derek-l8/vision-configured-analog-oscillator/data/pilot-s01/images/s01_p00_l0_r0_001.jpg

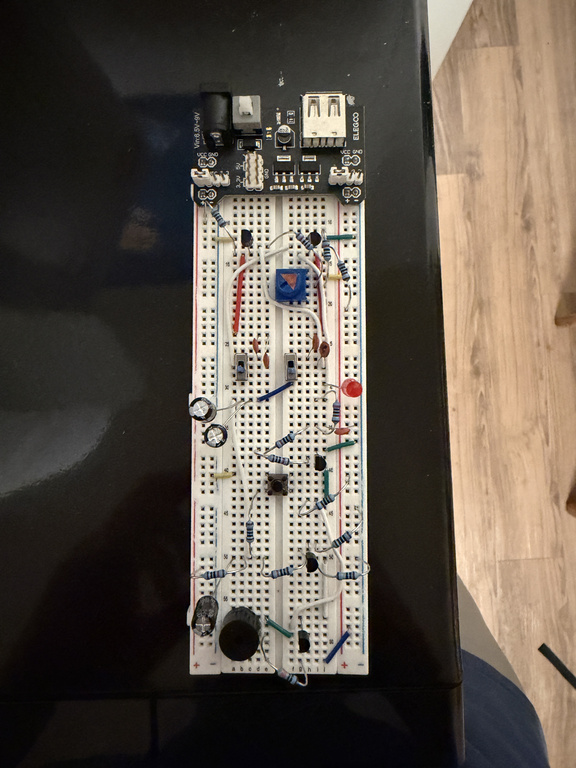
data/pilot-s01/images/s01_p00_l0_r0_001.jpg
