derek-l8/vision-configured-analog-oscillator/data/pilot-s01/images/s01_p00_l1_r0_002.jpg

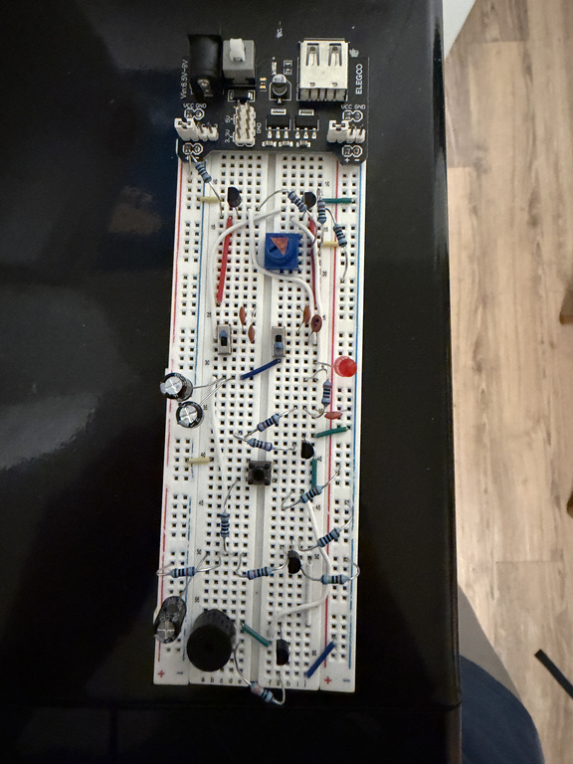
data/pilot-s01/images/s01_p00_l1_r0_002.jpg
