derek-l8/vision-configured-analog-oscillator/data/pilot-s01/images/s01_p00_l1_r1_003.jpg

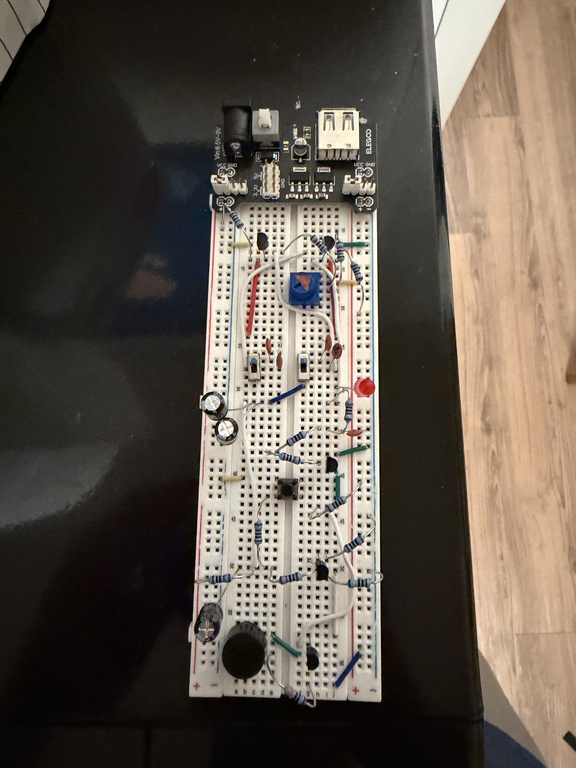
data/pilot-s01/images/s01_p00_l1_r1_003.jpg
