derek-l8/vision-configured-analog-oscillator/data/pilot-s01/images/s01_p01_l0_r0_005.jpg

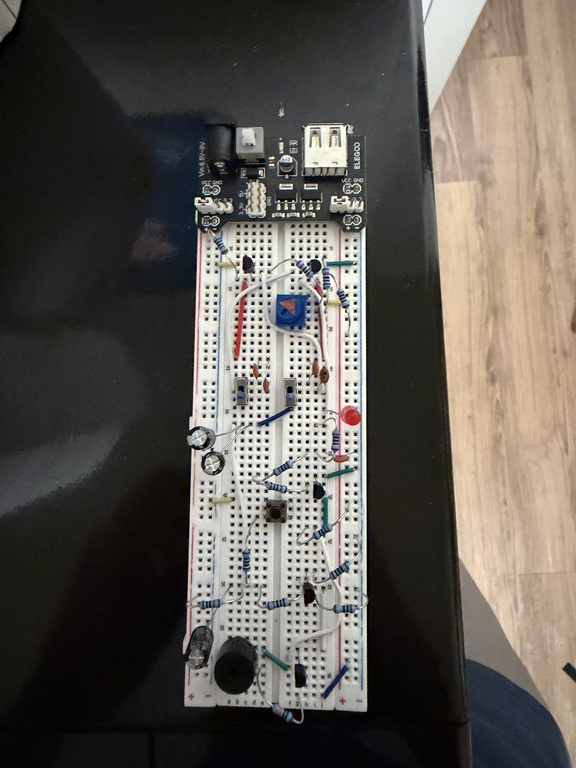
data/pilot-s01/images/s01_p01_l0_r0_005.jpg
