derek-l8/vision-configured-analog-oscillator/data/pilot-s01/images/s01_p01_l1_r0_006.jpg

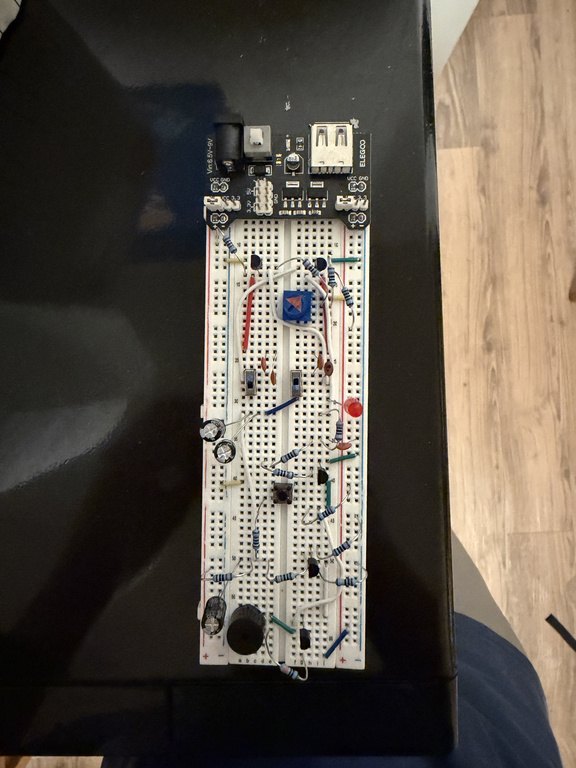
data/pilot-s01/images/s01_p01_l1_r0_006.jpg
