derek-l8/vision-configured-analog-oscillator/data/pilot-s01/images/s01_p02_l0_r1_012.jpg

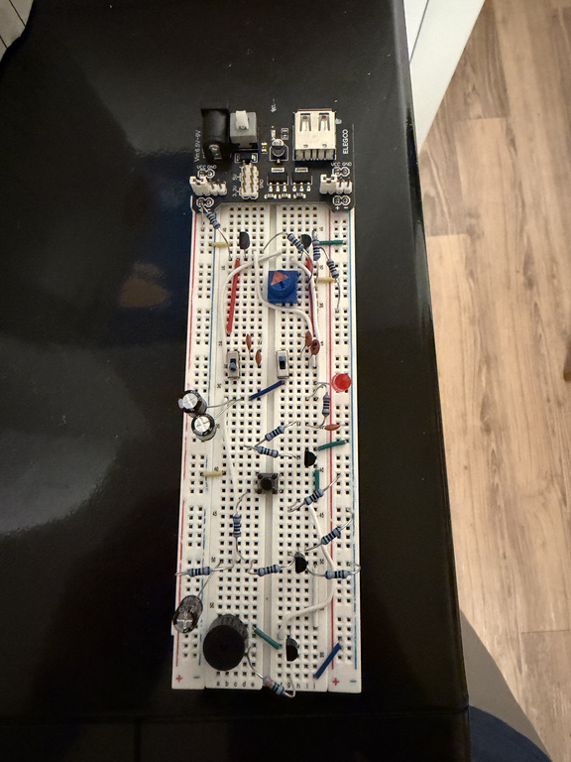
data/pilot-s01/images/s01_p02_l0_r1_012.jpg
