derek-l8/vision-configured-analog-oscillator/data/pilot-s01/images/s01_p02_l1_r1_011.jpg

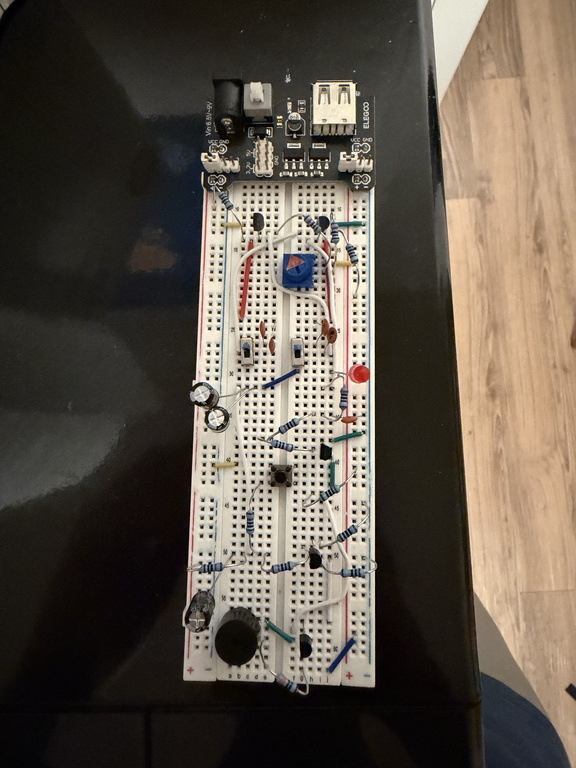
data/pilot-s01/images/s01_p02_l1_r1_011.jpg
