derek-l8/vision-configured-analog-oscillator/data/pilot-s01/images/s01_p03_l0_r0_013.jpg

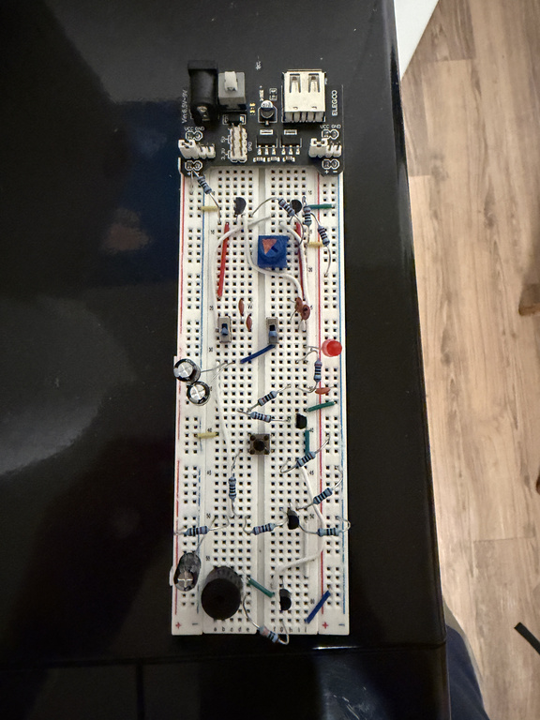
data/pilot-s01/images/s01_p03_l0_r0_013.jpg
