derek-l8/vision-configured-analog-oscillator/data/pilot-s01/images/s01_p03_l1_r0_014.jpg

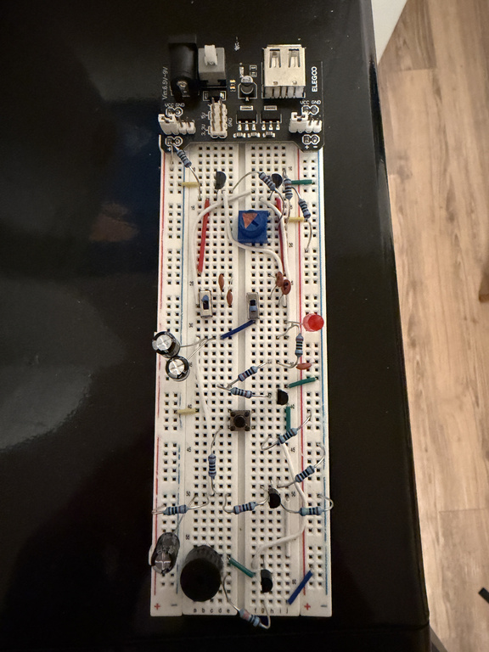
data/pilot-s01/images/s01_p03_l1_r0_014.jpg
