derek-l8/vision-configured-analog-oscillator/data/pilot-s01/images/s01_p04_l0_r0_017.jpg

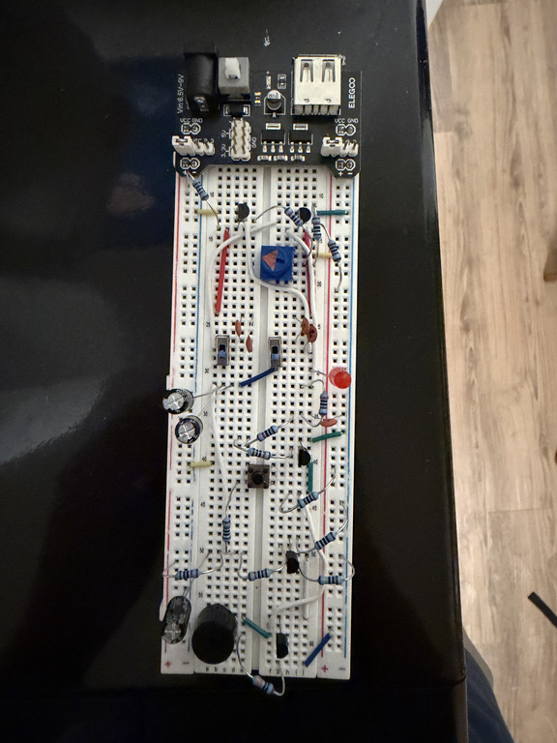
data/pilot-s01/images/s01_p04_l0_r0_017.jpg
