derek-l8/vision-configured-analog-oscillator/data/pilot-s01/images/s01_p04_l1_r1_019.jpg

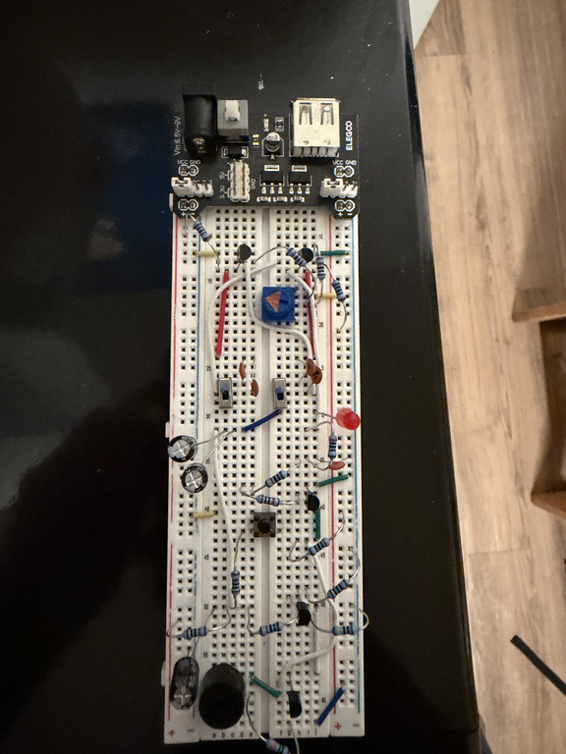
data/pilot-s01/images/s01_p04_l1_r1_019.jpg
