derek-l8/vision-configured-analog-oscillator/data/pilot-s01/images/s01_p05_l0_r0_021.jpg

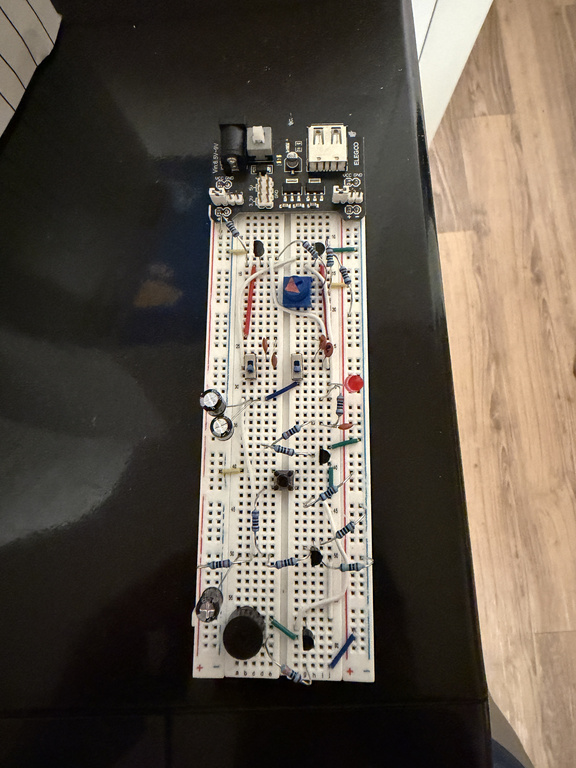
data/pilot-s01/images/s01_p05_l0_r0_021.jpg
