derek-l8/vision-configured-analog-oscillator/data/pilot-s01/images/s01_p05_l1_r0_022.jpg

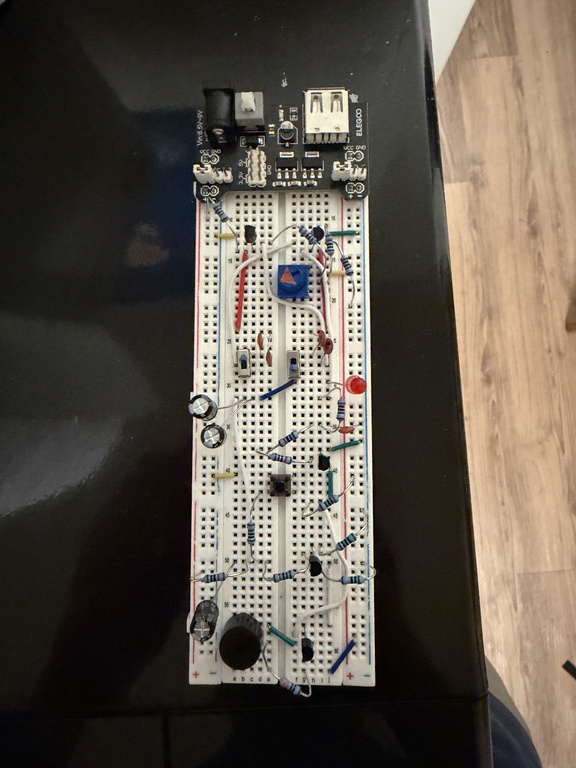
data/pilot-s01/images/s01_p05_l1_r0_022.jpg
