derek-l8/vision-configured-analog-oscillator/data/pilot-s01/images/s01_p06_l0_r1_028.jpg

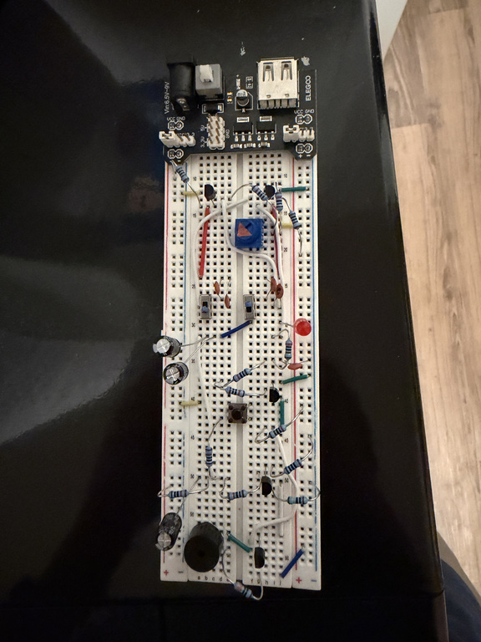
data/pilot-s01/images/s01_p06_l0_r1_028.jpg
