derek-l8/vision-configured-analog-oscillator/data/pilot-s01/images/s01_p06_l1_r1_027.jpg

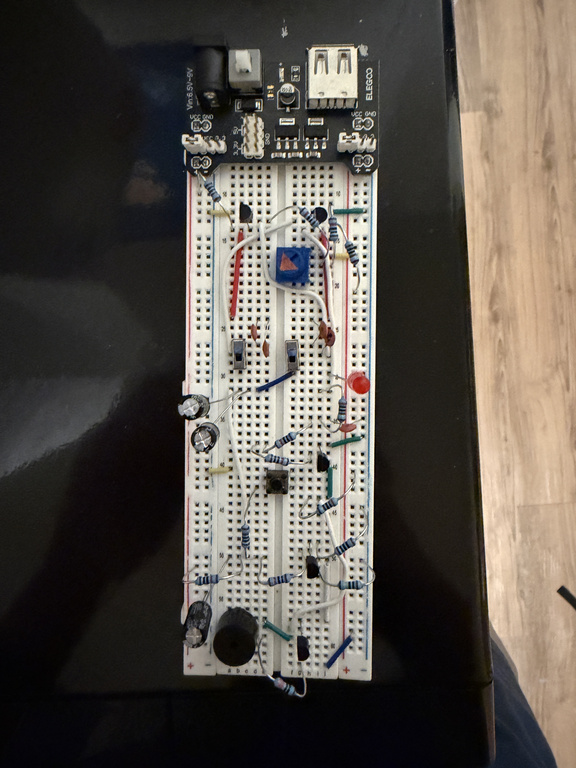
data/pilot-s01/images/s01_p06_l1_r1_027.jpg
