derek-l8/vision-configured-analog-oscillator/data/pilot-s01/images/s01_p07_l0_r0_029.jpg

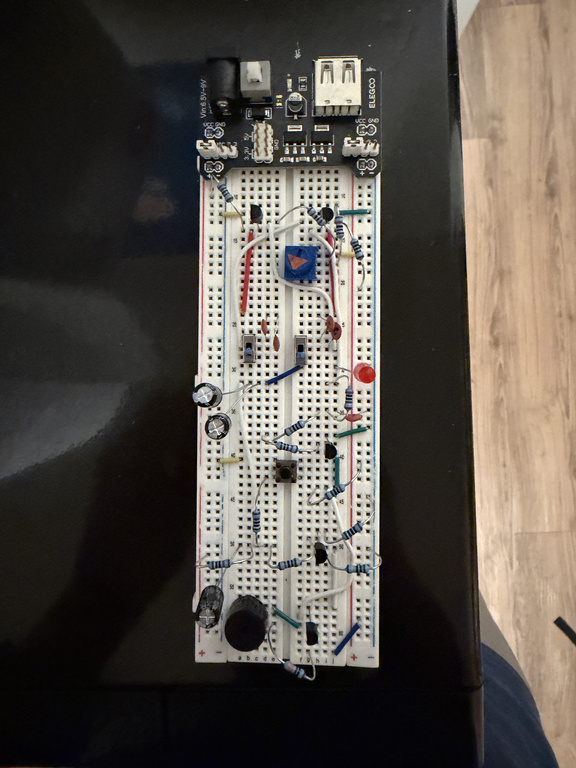
data/pilot-s01/images/s01_p07_l0_r0_029.jpg
