derek-l8/vision-configured-analog-oscillator/data/pilot-s01/images/s01_p07_l1_r0_030.jpg

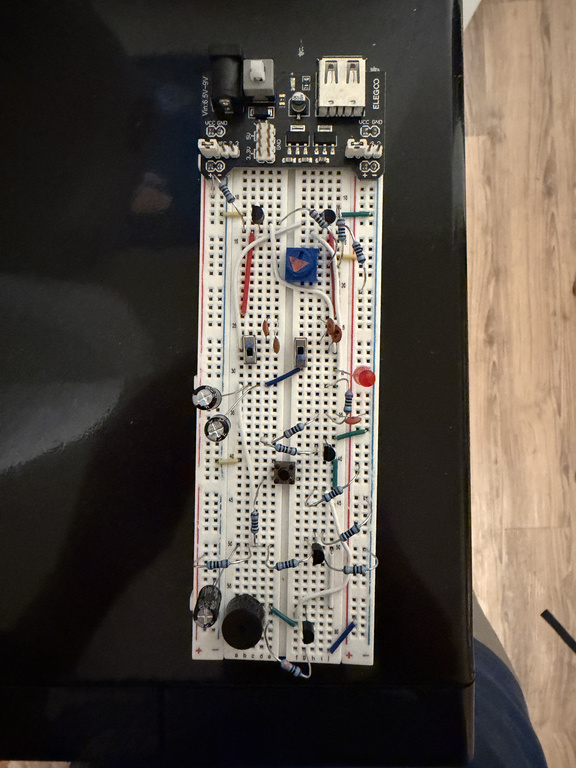
data/pilot-s01/images/s01_p07_l1_r0_030.jpg
