derek-l8/vision-configured-analog-oscillator/data/pilot-s01/images/s01_p08_l0_r0_033.jpg

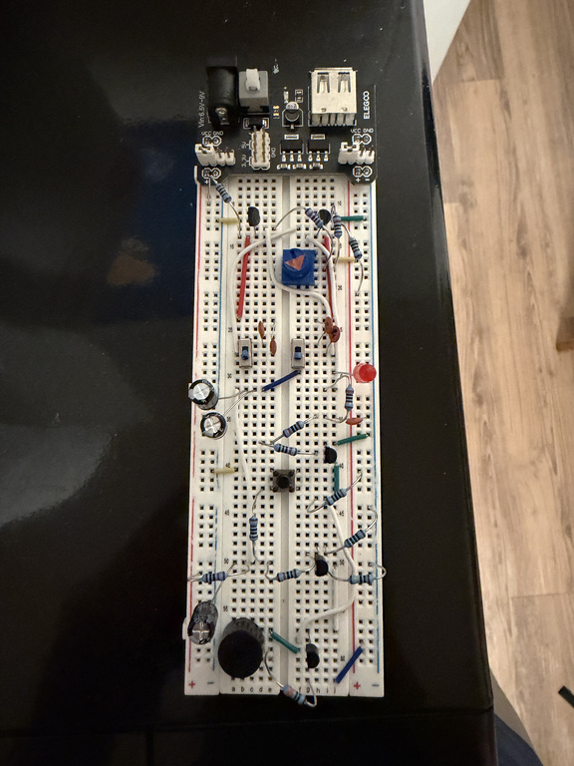
data/pilot-s01/images/s01_p08_l0_r0_033.jpg
