derek-l8/vision-configured-analog-oscillator/data/pilot-s01/images/s01_p09_l0_r0_037.jpg

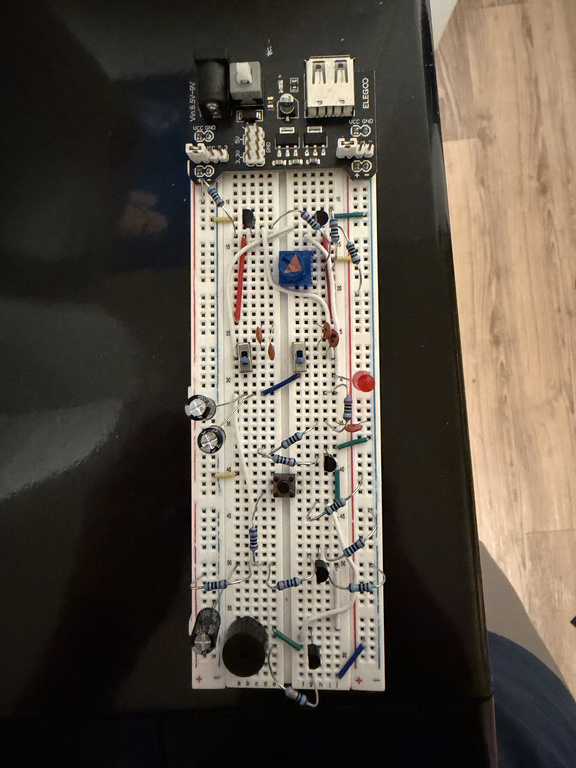
data/pilot-s01/images/s01_p09_l0_r0_037.jpg
