derek-l8/vision-configured-analog-oscillator/data/pilot-s01/images/s01_p09_l0_r1_040.jpg

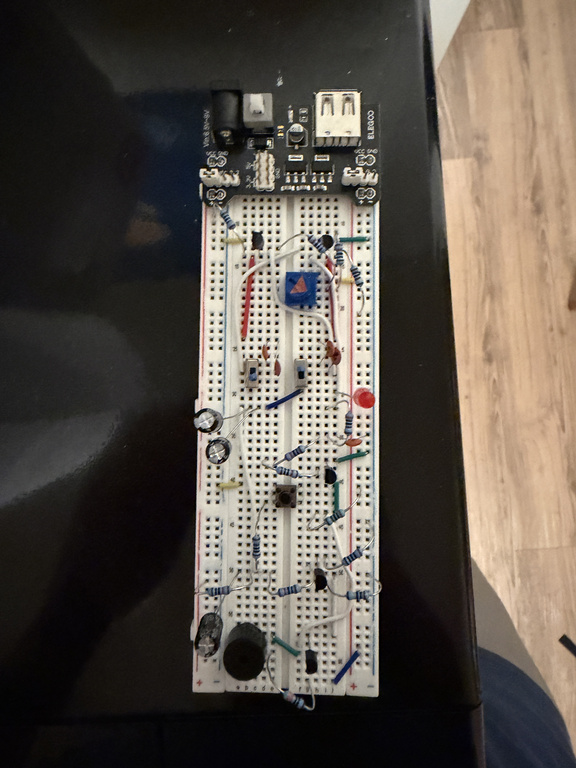
data/pilot-s01/images/s01_p09_l0_r1_040.jpg
