derek-l8/vision-configured-analog-oscillator/data/pilot-s01/images/s01_p09_l1_r1_039.jpg

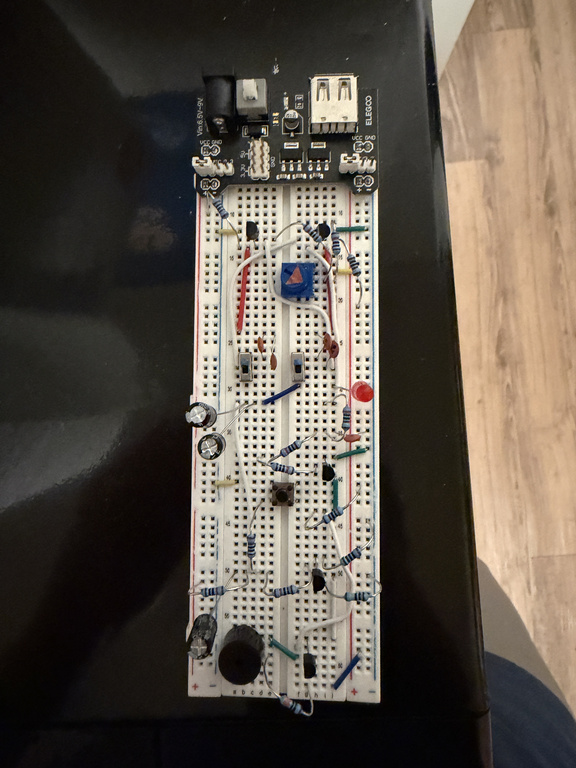
data/pilot-s01/images/s01_p09_l1_r1_039.jpg
