derek-l8/vision-configured-analog-oscillator/hardware/media/breadboard-overhead.JPG

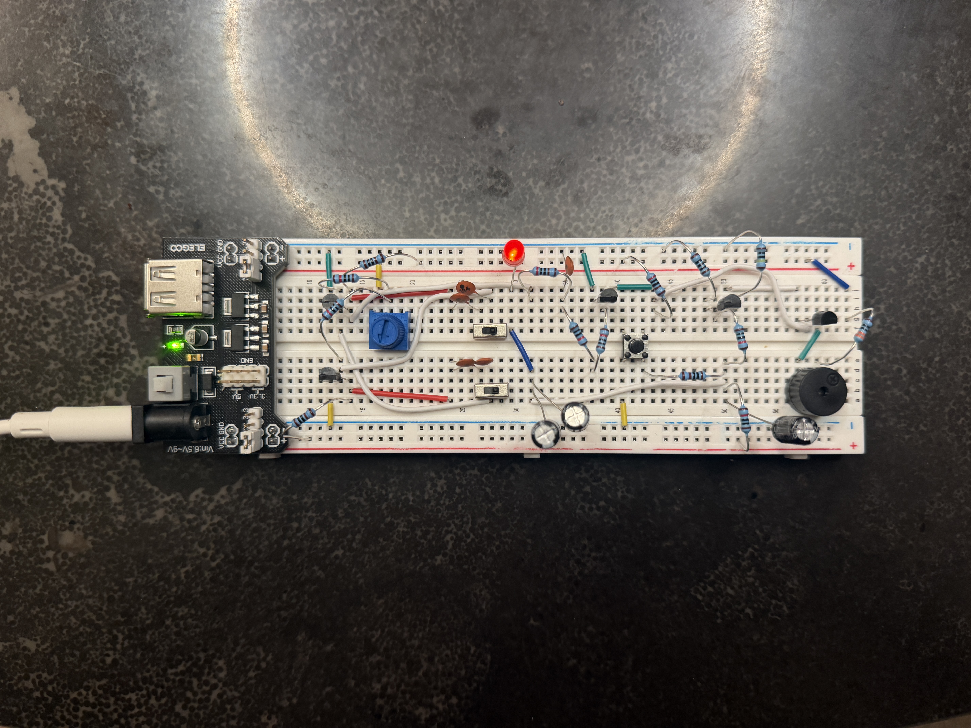
hardware/media/breadboard-overhead.JPG
