derek-l8/vision-configured-analog-oscillator/hardware/media/breadboard-side.JPG

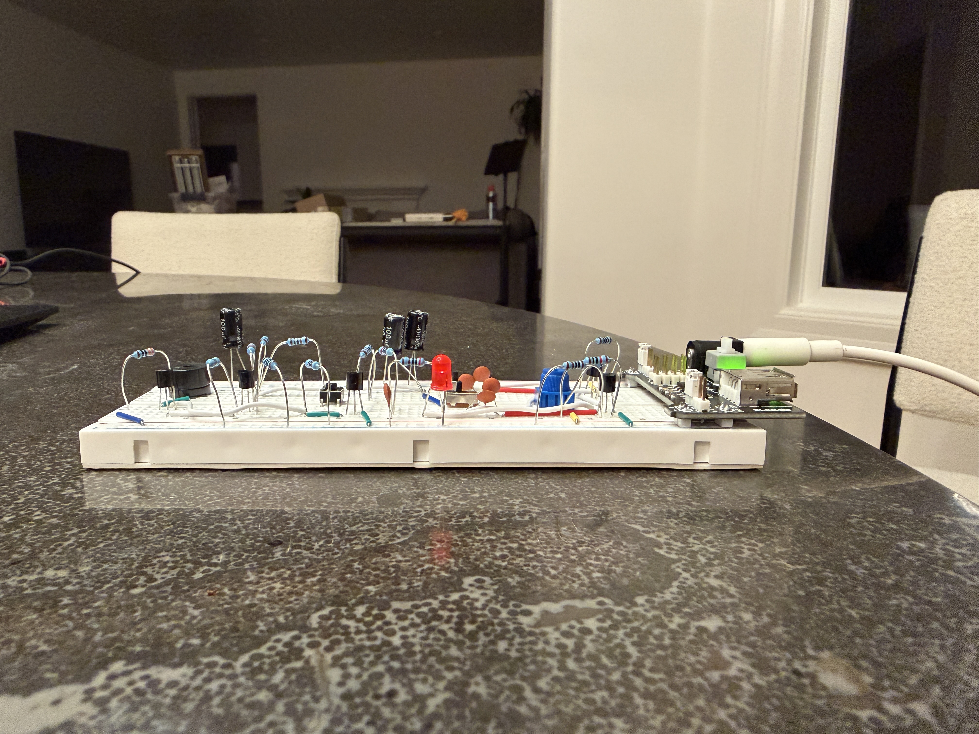
hardware/media/breadboard-side.JPG
