derek-l8/vision-configured-analog-oscillator/hardware/media/completed-breadboard.JPG

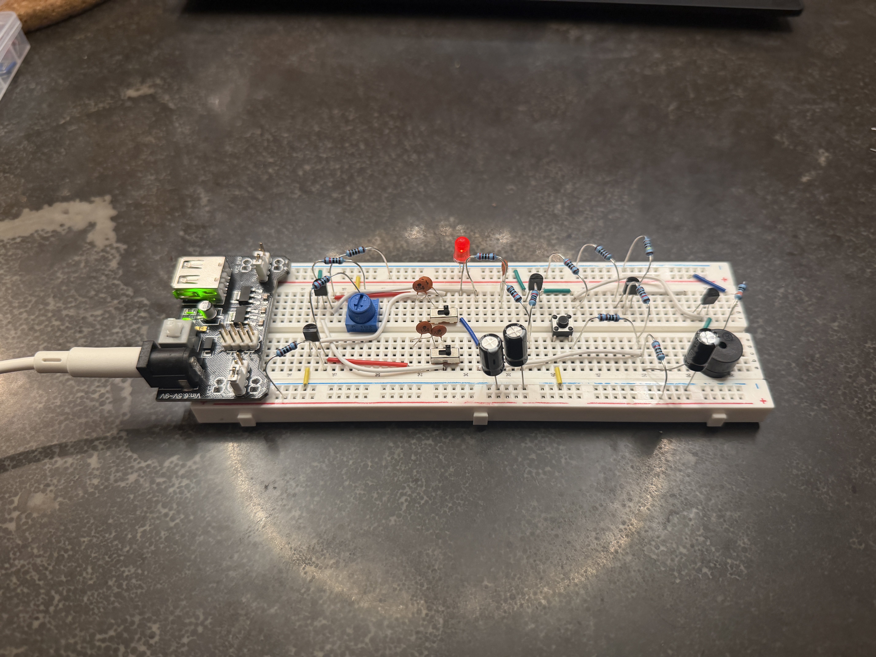
hardware/media/completed-breadboard.JPG
