derek-l8/vision-configured-analog-oscillator/hardware/media/controls-closeup.JPG

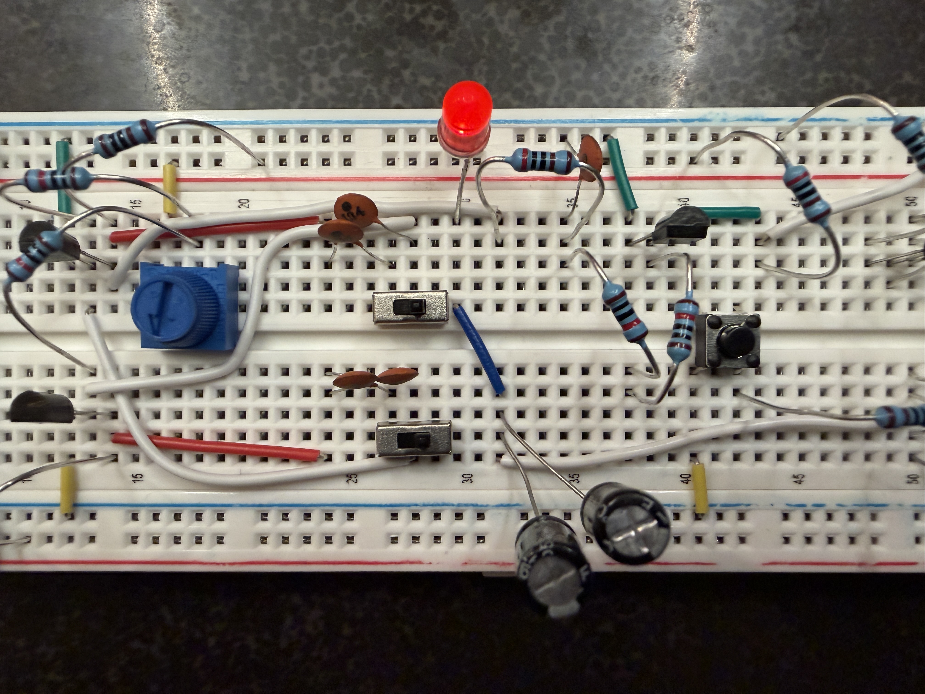
hardware/media/controls-closeup.JPG
