derek-l8/vision-configured-analog-oscillator/hardware/media/envelope-controls-closeup.JPG

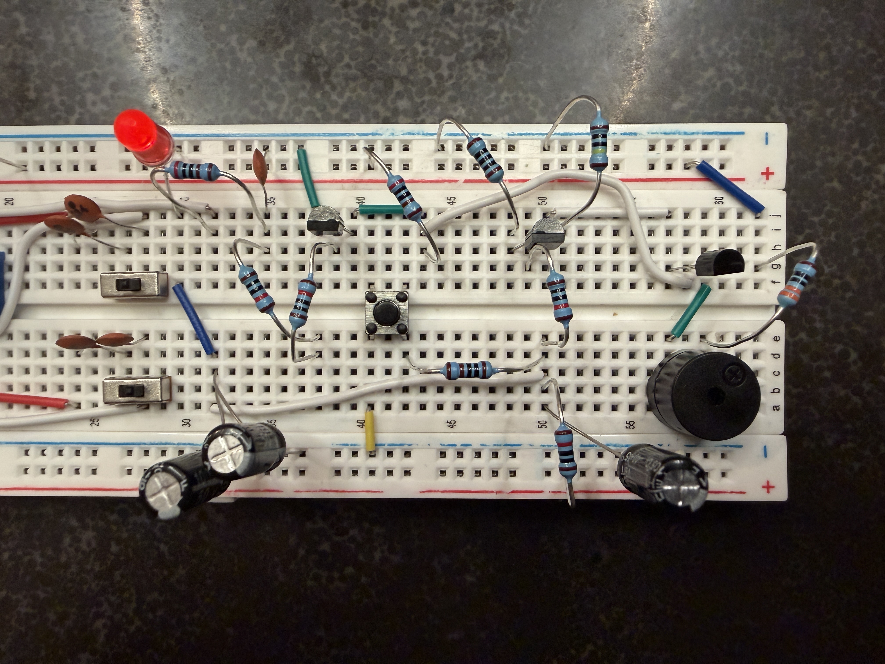
hardware/media/envelope-controls-closeup.JPG
