derek-l8/vision-configured-analog-oscillator/ltspice/analog-oscillator-v8.asc

C1: cap; 100n
C2: cap; 100n
C3: cap; 100n
C4: cap; {Cadd1}
C5: cap; {Cadd2}
C6: cap; 300µ
D1: diode; DRED
Q1: npn
Q2: npn
Q3: npn
Q4: npn
Q5: npn
R1: res; 10k
R2: res; 1k
R3: res; 10k
R4: res; 1k
R5: res; 2k
R6: res; {Rp}
R7: res; 2k
R8: res; 20k
R9: res; 1Meg
R10: res; 10k
R11: res; 10k
R12: res; 1k
R13: res; 100
R14: res; 10k
R15: res; 330
RBUZ: res; 16
S1: sw; SWMOD
V1: voltage; 5
Named nets: 0, O1, O2, B1, B2, FILT, T, BP, BUZ, DRIVE, GATE, ENV, BTN, LEDA
.param Rp=5.1k
.param Cadd1=1p
.param Cadd2=1p
 
; One 1-second simulated button hold after ENV has charged.
VBTN BTN 0 PULSE(0 5 6 1m 1m 1 15)
.model SWMOD SW(Ron=0.1 Roff=1G Vt=2 Vh=0)
 
; Approximate red LED model.
.model DRED D(Is=2e-20 N=2 Rs=10)
 
.options method=gear gmin=1n cshunt=1p
.tran 0 12 0 20u startup
.ic V(O1)=4.8 V(O2)=0.2
 
.meas tran Inormal RMS I(RBUZ) FROM 5.2 TO 5.7
.meas tran Iheld RMS I(RBUZ) FROM 6.7 TO 6.9
.meas tran Irecovered RMS I(RBUZ) FROM 11.2 TO 11.5
 
.meas tran Tnormal TRIG V(O1) VAL=2.5 RISE=1 TD=5 TARG V(O1) VAL=2.5 RISE=2 TD=5
.meas tran Theld TRIG V(O1) VAL=2.5 RISE=1 TD=6.7 TARG V(O1) VAL=2.5 RISE=2 TD=6.7
.meas tran Fnormal PARAM 1/Tnormal
.meas tran Fheld PARAM 1/Theld
.meas tran PitchShiftPct PARAM 100*(Fheld-Fnormal)/Fnormal
; FILT is the low-pass oscillator output and feeds Q3's input.
; Q3 isolates the oscillator from the buzzer driver; Q5 switches buzzer current.
 
; ENV is normally high, turning Q4 on and completing Q5's emitter return path.
; Holding the button discharges ENV through R12, reducing Q4 current and muting the buzzer.
; Q4 has a 100-ohm emitter resistor for a less abrupt electrical transition.
 
; C6 is three 100 uF electrolytics in parallel: 300 uF total.
; All C6 positive terminals connect to ENV; all negative terminals connect to ground.
 
; ENV also drives a red LED through a 10k resistor to ground.
; The LED visually shows ENV falling while held and recharging after release.
 
; The simulated button is held from 6 s to 7 s.
; Generic transistor and LED models validate circuit behavior, not exact PN2222 gain,
; exact LED brightness, or buzzer loudness.
