derek-l8/vision-configured-analog-oscillator/(commit log)

2026-10-05 Implement CV pipeline and document first training experiments
    Implement preprocessing, annotation, training, evaluation, and prediction.
    Include 40 metadata-scrubbed training photos and manual labels.
    Document training experiments and results
    [capture-plan.csv, pilot-capture-plan.csv]
2026-11-12 Move demo videos to YouTube and tighten public docs
    Replace the GitHub-hosted video embeds with links to correctly oriented
    unlisted YouTube uploads, and remove the three original demo MP4s that
    no page references (two were wrongly oriented). They remain in history.
    Add a test step to the verification guide, consolidate repeated
    checkpoint caveats, note that experiment evidence paths are local, and
    drop a stale demo-video remark from the CV development notes.
